ChristianMoesl/artnet-dmx-controller/ArtNet_DMX_Controller.brd

## EAGLE design ArtNet_DMX_Controller.brd (2016-10-19)

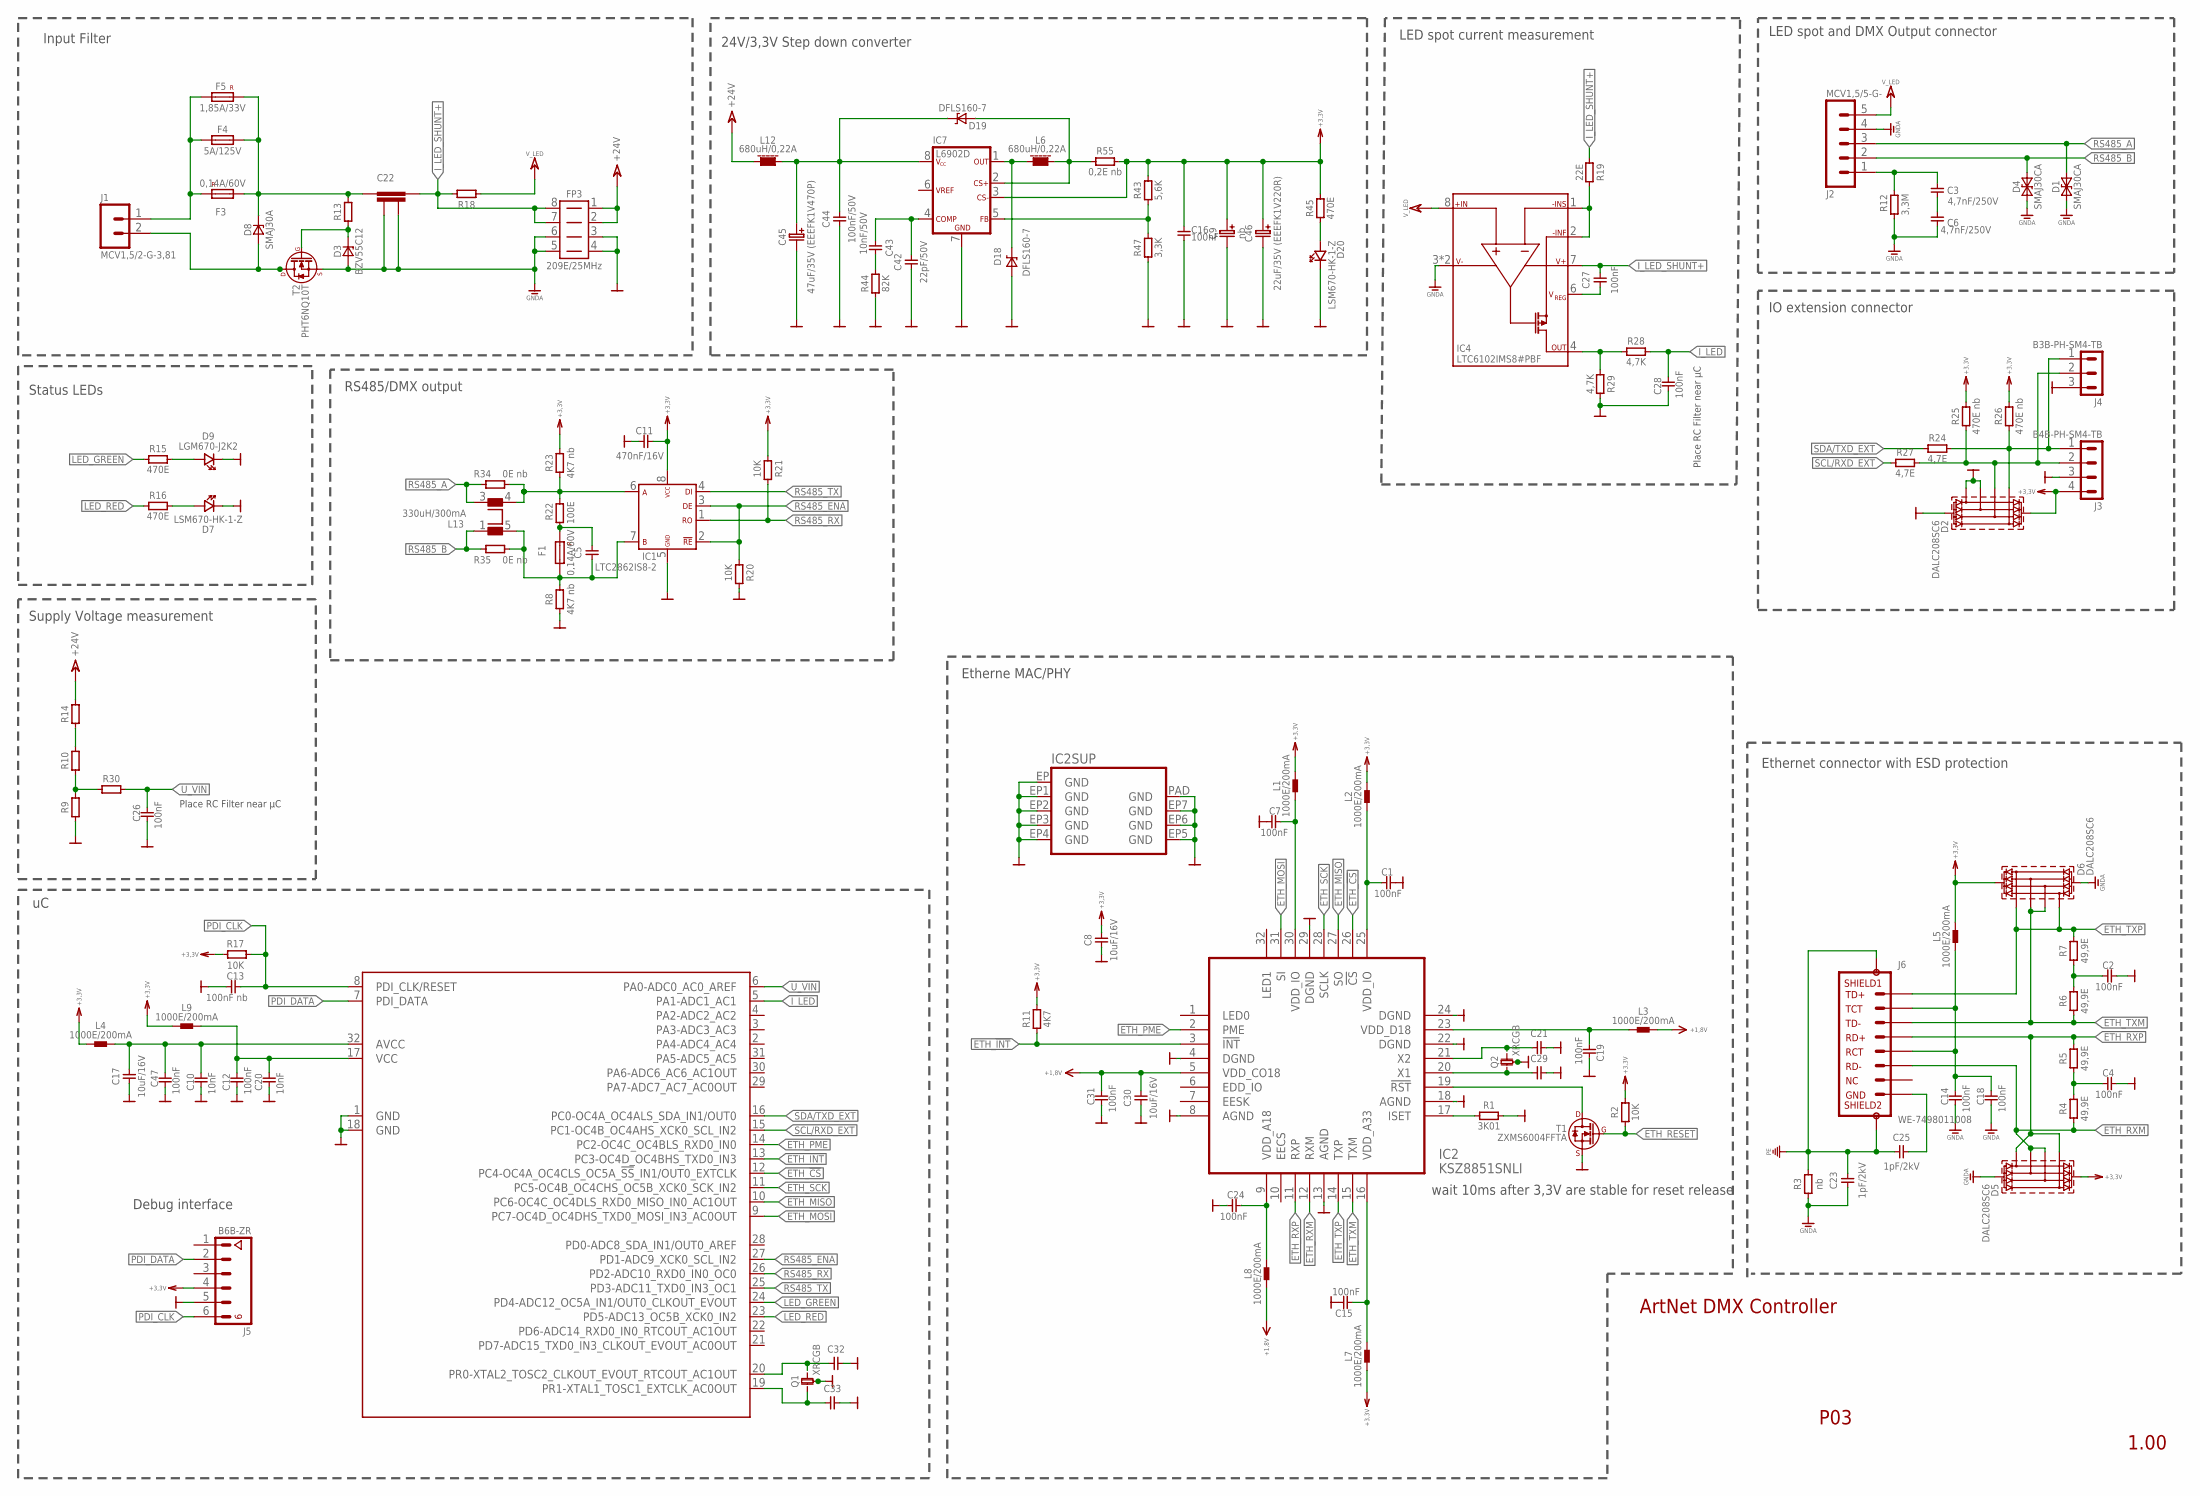
[picture p2: schematic ArtNet_DMX_Controller.sch]

Parts:
C1, C2, C4, C7, C12, C14, C15, C16, C18, C19, C24, C26, C28, C31, C47: 100nF; 0603
C3, C6: 4,7nF/250V; 2220
C5: C-0805; 0805
C8, C17, C30: 10uF/16V; 0805
C9: nb; 6032
C10, C20: 10nF; 0603
C11: 470nF/16V; 0603
C13: 100nF nb; 0603
C21, C29, C32, C33: C-0603; 0603
C22: NFM55P
C23, C25: 1pF/2kV; 1206
C27: 100nF; 0805
C42: 22pF/50V; 0603
C43: 10nF/50V; 0603
C44: 100nF/50V; 0805
C45: 47uF/35V (EEEFK1V470P); PANASONIC-SIZE-CODE-D
C46: 22uF/35V (EEEFK1V220R); PANASONIC-SIZE-CODE-D
D1, D4: SMAJ30CA; DO-214AC
D2, D5, D6: DALC208SC6; SOT23-6L
D3: BZV55C12; SOD80C
D7, D20: LSM670-HK-1-Z; M670
D8: SMAJ30A; DO-214AC
D9: LGM670-J2K2; M670
D18, D19: DFLS160-7; POWERDI123
F1, F3: 0,14A/60V; 1812L
F4: 5A/125V; 6.1X2.69MM
F5: 1,85A/33V; 2920L
FP3: 209E/25MHz; WE-MLS-10,88MMX5,49MM
IC1: LTC2862IS8-2; SO8
IC2: KSZ8851SNLI; QFN32_5X5
IC3: E5-TQFP; TQFP32
IC4: LTC6102IMS8#PBF; MS8
IC7: L6902D; SO8
J1: MCV1,5/2-G-3,81
J2: MCV1,5/5-G-; MCV1,5/5-G-3,81_MOD
J3: B4B-PH-SM4-TB
J4: B3B-PH-SM4-TB
J5: B6B-ZR
J6: WE-7498011008; WE-749801108
L1, L2, L3, L4, L5, L7, L8, L9: 1000E/200mA; 0603
L6, L12: 680uH/0,22A; 73XX
L13: 330uH/300mA; WE-SL1
Q1, Q2: XRCGB
R1: 3K01; 0603
R2, R17, R20, R21: 10K; 0603
R3: nb; 1206
R4, R5, R6, R7: 49,9E; 0603
R8, R23: 4K7 nb; 0805
R9, R10, R14, R30: R-0603; 0603
R11: 4K7; 0603
R12: 3,3M; 0207
R13: R-0805; 0805
R15, R16, R45: 470E; 0603
R18: R-2512; 2512
R19: 22E; 0603
R22: 100E; 0207
R24, R27: 4,7E; 0603
R25, R26: 470E nb; 0603
R28, R29: 4,7K; 0603
R34, R35: 0E nb; 0805
R43: 5,6K; 0603
R44: 82K; 0603
R47: 3,3K; 0603
R55: 0,2E nb; 0805
T1: ZXMS6004FFTA; SOT-23
T2: PHT6NQ10T; SOT223

Connections:
+1,8V: C30.2, C31.2, IC2.5 (VDD_CO18), L3.2, L8.1
+3,3V: C8.1, C9.PLUS (+), C11.2, C16.2, C46.+, D2.2 (REF2), D5.2 (REF2), D6.2 (REF2), IC1.8 (VCC), IC7.3 (CS-), J3.4, J5.4, L1.2, L2.2, L4.1, L5.2, L7.1, L9.1, R2.2, R11.2, R17.2, R21.2, R23.2, R25.2, R26.2, R43.2, R45.2, R55.2
+24V: FP3.1, FP3.2, L12.1, R14.2
AVCC: C10.2, C17.2, C47.2, IC3.32 (AVCC), L4.2
BLA: C5.1, F1.1, IC1.7 (B), L13.5 (2), R8.2, R35.2
BLA2: IC1.6 (A), L13.4 (3), R22.2, R23.1, R34.2
ETH_!CS: IC2.26 (!CS), IC3.12 (PC4-OC4A_OC4CLS_OC5A_!SS!_IN1/OUT0_EXTC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)
ETH_!INT: IC2.3 (!INT), IC3.13 (PC3-OC4D_OC4BHS_TXD0_IN3), R11.1
ETH_MISO: IC2.27 (SO), IC3.10 (PC6-OC4C_OC4DLS_RXD0_MISO_IN0_AC1OUT)
ETH_MOSI: IC2.31 (SI), IC3.9 (PC7-OC4D_OC4DHS_TXD0_MOSI_IN3_AC0OUT)
ETH_PME: IC2.2 (PME), IC3.14 (PC2-OC4C_OC4BLS_RXD0_IN0)
ETH_RESET: R2.1, T1.1 (G)
ETH_RXM: D5.3 (I/O2), D5.4 (I/O3), IC2.12 (RXM), J6.P$6 (RD-), R4.1
ETH_RXP: D5.1 (I/O1), D5.6 (I/O4), IC2.11 (RXP), J6.P$3 (RD+), R5.2
ETH_SCK: IC2.28 (SCLK), IC3.11 (PC5-OC4B_OC4CHS_OC5B_XCK0_SCK_IN2)
ETH_TXM: D6.3 (I/O2), D6.4 (I/O3), IC2.15 (TXM), J6.P$2 (TD-), R6.1
ETH_TXP: D6.1 (I/O1), D6.6 (I/O4), IC2.14 (TXP), J6.P$1 (TD+), R7.2
GND: C1.2, C2.2, C4.2, C7.2, C8.2, C9.MINUS (-), C10.1, C11.1, C12.1, C13.2, C15.2, C16.1, C17.1, C19.2, C20.1, C21.2, C24.1, C26.1, C28.1, C29.2, C30.1, C31.1, C32.2, C33.2, C42.1, C44.1, C45.-, C46.-, C47.1, D2.1 (I/O1), D2.3 (I/O2), D2.5 (REF1), D7.K, D9.K, D18.A, D20.K, FP3.3, FP3.4, IC1.5 (GND), IC2.4 (DGND), IC2.8 (AGND), IC2.13 (AGND), IC2.18 (AGND), IC2.22 (DGND), IC2.24 (DGND), IC2.29 (DGND), IC2.EP (GND), IC2.EP1 (GND), IC2.EP2 (GND), IC2.EP3 (GND), IC2.EP4 (GND), IC2.EP5 (GND), IC2.EP6 (GND), IC2.EP7 (GND), IC2.PAD (GND), IC3.1 (GND), IC3.18 (GND), IC7.7 (GND), J3.3, J4.3, J5.5, Q1.3, Q1.4, Q2.3, Q2.4, R1.2, R8.1, R9.1, R20.1, R29.2, R44.1, R47.1, T1.2 (S)
GNDA: C6.P$1 (1), C14.1, C18.1, C22.3, C22.4, C23.1, D1.K (2), D3.A, D4.K (2), D5.5 (REF1), D6.5 (REF1), FP3.5, FP3.6, IC4.3 (V-), IC4.5 (V-), J2.4, R3.1, R12.1, T2.3 (S)
I_LED: C28.2, IC3.5 (PA1-ADC1_AC1), R28.2
I_LED_SHUNT+: C22.2, C27.2, FP3.7, FP3.8, IC4.7 (V+), R18.2, R19.1
LED_GREEN: IC3.24 (PD4-ADC12_OC5A_IN1/OUT0_CLKOUT_EVOUT), R15.1
LED_RED: IC3.23 (PD5-ADC13_OC5B_XCK0_IN2), R16.1
unnamed: IC2.17 (ISET), R1.1
unnamed: C3.P$2 (2), J2.1, R12.2
unnamed: IC2.19 (!RST), T1.3 (D)
unnamed: C7.1, IC2.30 (VDD_IO), L1.1
unnamed: C1.1, IC2.25 (VDD_IO), L2.1
unnamed: C5.2, F1.2, R22.1
unnamed: D3.K, R13.1, T2.1 (G)
unnamed: C27.1, IC4.6 (VREG)
unnamed: C3.P$1 (1), C6.P$2 (2)
unnamed: C25.2, J6.P$8 (GND)
unnamed: D9.A, R15.2
unnamed: D7.A, R16.2
unnamed: C29.1, IC2.20 (X1), Q2.1
unnamed: C32.1, IC3.20 (PR0-XTAL2_TOSC2_CLKOUT_EVOUT_RTCOUT_AC1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), Q1.2
unnamed: F3.2, F4.1, F5.1, J1.1
unnamed: C33.1, IC3.19 (PR1-XTAL1_TOSC1_EXTCLK_AC0OUT), Q1.1
unnamed: R10.2, R14.1
unnamed: IC4.4 (OUT), R28.1, R29.1
unnamed: C22.1, D8.K, F3.1, F4.2, F5.2, R13.2
unnamed: C15.1, IC2.16 (VDD_A33), L7.2
unnamed: R9.2, R10.1, R30.1
unnamed: D2.6 (I/O4), J3.1, J4.1, R24.2, R26.1
unnamed: C21.1, IC2.21 (X2), Q2.2
unnamed: D2.4 (I/O3), J3.2, J4.2, R25.1, R27.2
unnamed: C14.2, C18.2, J6.P$4 (TCT), J6.P$5 (RCT), L5.1
unnamed: C2.1, R6.2, R7.1
unnamed: C24.2, IC2.9 (VDD_A18), L8.2
unnamed: D8.A, J1.2, T2.2 (D), T2.4 (D1)
unnamed: C4.1, R4.2, R5.1
unnamed: IC4.1 (-INS), IC4.2 (-INF), R19.2
unnamed: IC7.5 (FB), R43.1, R47.2
unnamed: D19.A, IC7.2 (CS+), L6.2, R55.1
unnamed: D18.K, IC7.1 (OUT), L6.1
unnamed: C42.2, C43.1, IC7.4 (COMP)
unnamed: C43.2, R44.2
unnamed: D20.A, R45.1
unnamed: C44.2, C45.+, D19.K, IC7.8 (VCC), L12.2
PDI_CLK: C13.1, IC3.8 (PDI_CLK/RESET), J5.6, R17.1
PDI_DATA: IC3.7 (PDI_DATA), J5.2
PE: C23.2, C25.1, J6.P$9 (9), J6.P$10 (10), R3.2
RS485_A: D1.A (1), J2.3, L13.3 (4), R34.1
RS485_B: D4.A (1), J2.2, L13.1, R35.1
RS485_ENA: IC1.2 (/RE), IC1.3 (DE), IC3.27 (PD1-ADC9_XCK0_SCL_IN2), R20.2
RS485_RX: IC1.1 (R0), IC3.26 (PD2-ADC10_RXD0_IN0_OC0), R21.1
RS485_TX: IC1.4 (DI), IC3.25 (PD3-ADC11_TXD0_IN3_OC1)
SCL/RXD_EXT: IC3.15 (PC1-OC4B_OC4AHS_XCK0_SCL_IN2), R27.1
SDA/TXD_EXT: IC3.16 (PC0-OC4A_OC4ALS_SDA_IN1/OUT0), R24.1
U_VIN: C26.2, IC3.6 (PA0-ADC0_AC0_AREF), R30.2
VCC: C12.2, C20.2, IC3.17 (VCC), L9.2
VDD_D18: C19.1, IC2.23 (VDD_D18), L3.1
V_LED: IC4.8 (+IN), J2.5, R18.1

Notes on the sheet:
wait 10ms after 3,3V are stable for reset release
Place RC Filter near µC
Supply Voltage measurement
Debug interface
Input Filter
Status LEDs
RS485/DMX output
24V/3,3V Step down converter
LED spot current measurement
LED spot and DMX Output connector
IO extension connector
Ethernet connector with ESD protection
Etherne MAC/PHY
ArtNet DMX Controller
P03
1.00

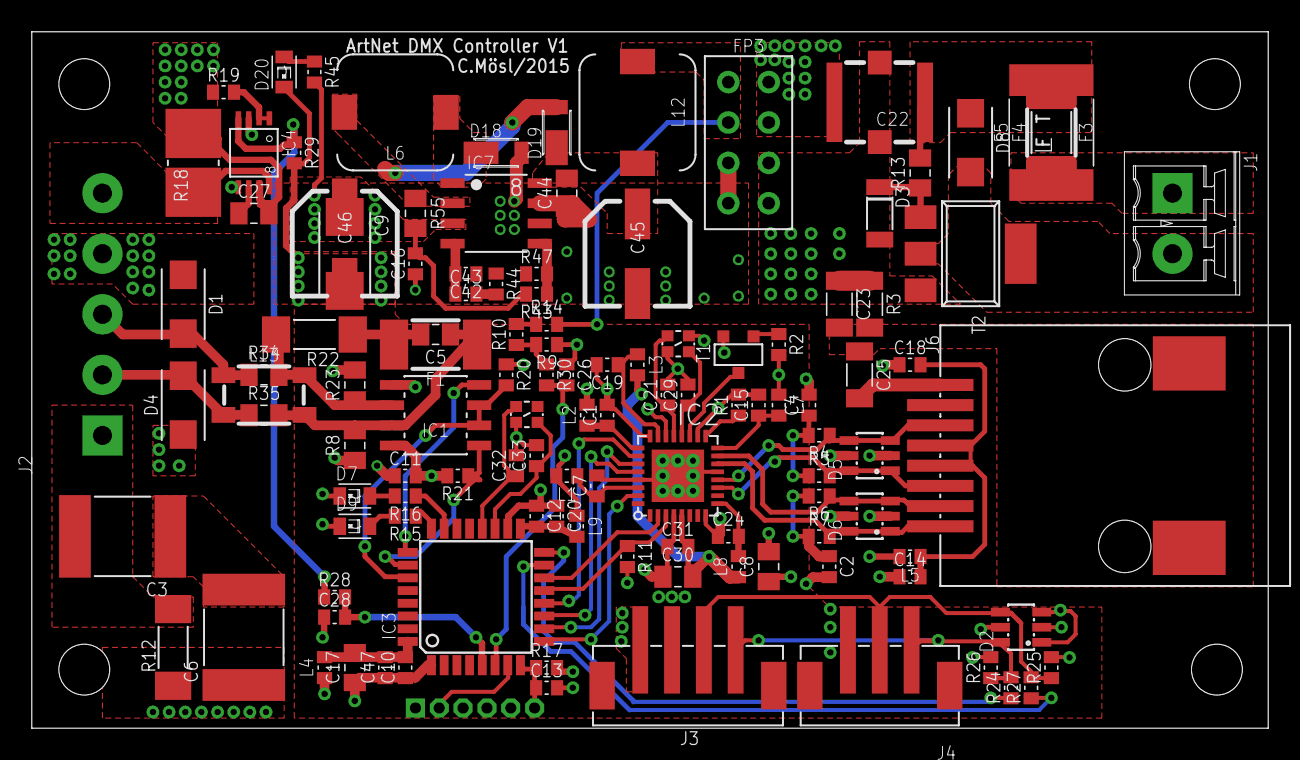
[picture p3: board ArtNet_DMX_Controller.brd from above]

Board: 4 copper layers, 77.8 x 43.8 mm, 119 parts (1 on the bottom side), 74 nets.
