ChristianMoesl/artnet-dmx-controller/(threads)

Thread 1 (2016-10-19):

Direct control per Wallswitch

ChristianMoesl, 2016-10-19:
There should realy be an easy way to turn on all the LED's through a simple wall mounted switch.

Closed 2019-04-08.

Thread 2 (2016-10-19):

DALC208 wired wrong

ChristianMoesl, 2016-10-19:
The ESD protection diodes of the type DALC208 are wired up in the wrong way. They should be removed or rewired to prevent them from modifying the ETH_RXM and ETH_TXM signal.

Closed 2019-04-08.

Thread 3 (2016-10-19):

KSZ8851SNL reset line unconnected

ChristianMoesl, 2016-10-19:
The KSZ8851SNL reset line should be either connected to GND or to the uC.

Closed 2019-04-08.
